bytesandbolts/lettera/pietroleoni_letteraREV1/Lettera Cost sheet.pdf

Item | Unit Price | Units | Subtotal
Phidgets 3314_0 - 950g-cm Unipolar Stepper. (x2) | 7.14 | 1 | 7.14
Seed Studio general shaft joint -p3. (x2) | 1.99 | 2 | 3.98
LM8UU linear bearings. (x7) | 3.56 | 2 | 7.14
Hitech standard servo, able to operate at 5V. | 16.29 | 1 | 16.29
Microswitch. (x2) | 2.2 | 1 | 2.2
L293D | 1.29 | 2 | 2.58
7805T | 4.05 | 1 | 4.05
Total | 43.38

http://www.active-robots.com/pm42l-048-17-950g-cm-unipolar-stepperhttp://www.amazon.co.uk/SeeedStudio-General-Shaft-Source-BOOOLE/dp/B00WX2IKOGhttp://www.amazon.co.u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
http://www.amazon.co.uk/Hitec-Standard-HS-311Storage-Gears-Polyamide/dp/B0006O3WVEhttp://www.amazon.co.uk/10pcs-Tact-Switch-KW11-3Z-Microswitch/dp/B014LY9LEQ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
