bytesandbolts/lettera/(list of files, cad)

Other CAD files:
pietroleoni_letteraREV1/pietroleoni_letteraREV1.dxf
