bytesandbolts/lettera/pietroleoni_letteraREV1/pietroleoni_letteraREV1_manual.pdf

# lettera

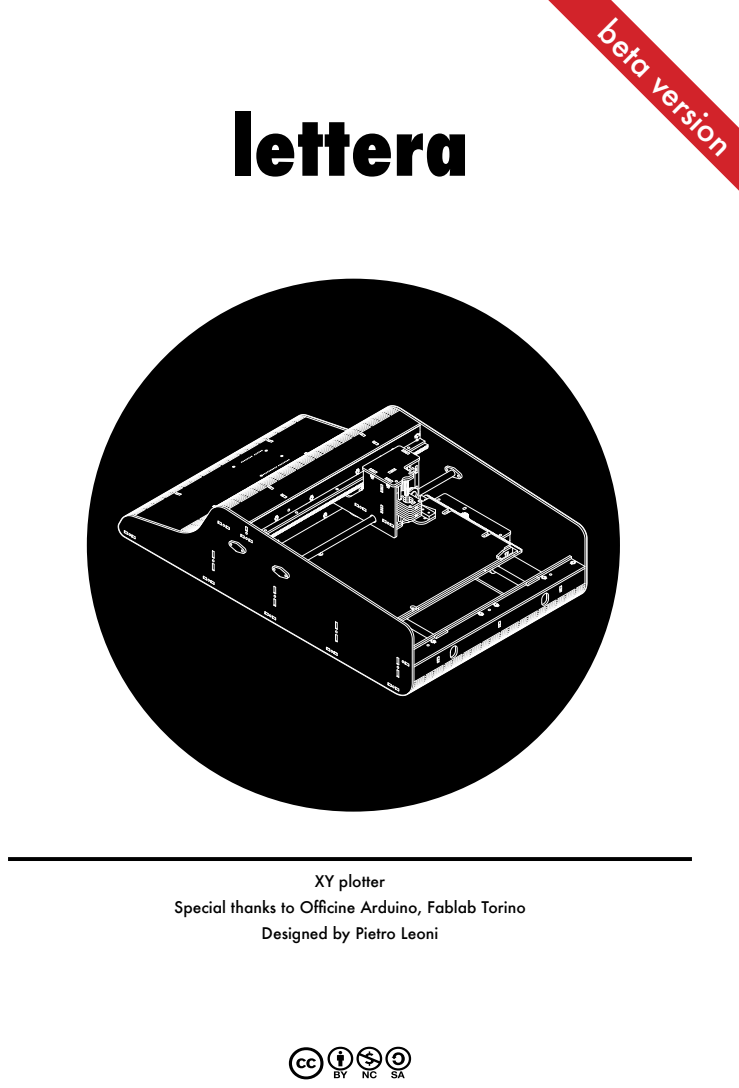
[picture p1: page 1]
beta version; XY plotter

Special thanks to Officine Arduino, Fablab Torino

Designed by Pietro Leoni

# connections and components

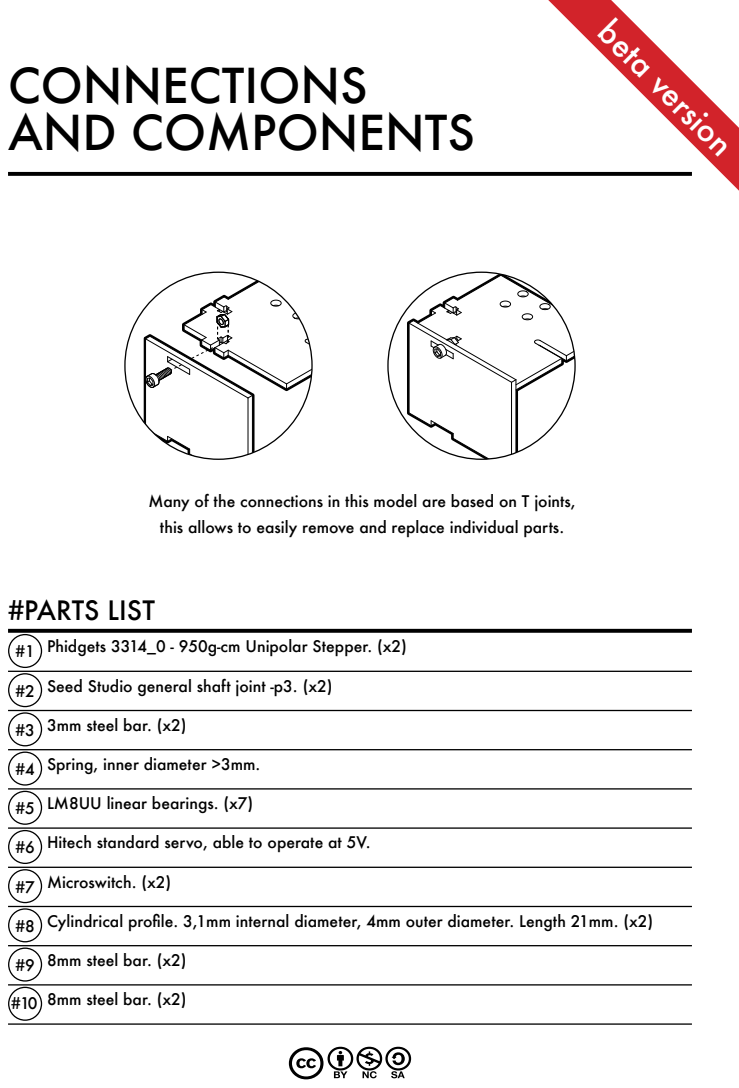
[picture p2: page 2]
beta version; #parts list

Many of the connections in this model are based on T joints,
this allows to easily remove and replace individual parts.

#1 Phidgets 3314_0 - 950g-cm Unipolar Stepper. (x2)
#2 Seed Studio general shaft joint -p3. (x2)
#3 3mm steel bar. (x2)
#4 Spring, inner diameter >3mm.
#5 LM8UU linear bearings. (x7)
#6 Hitech standard servo, able to operate at 5V.
#7 Microswitch. (x2)
#8 Cylindrical profile. 3,1mm internal diameter, 4mm outer diameter. Length 21mm. (x2)
#9 8mm steel bar. (x2)
#10 8mm steel bar. (x2)

# plans

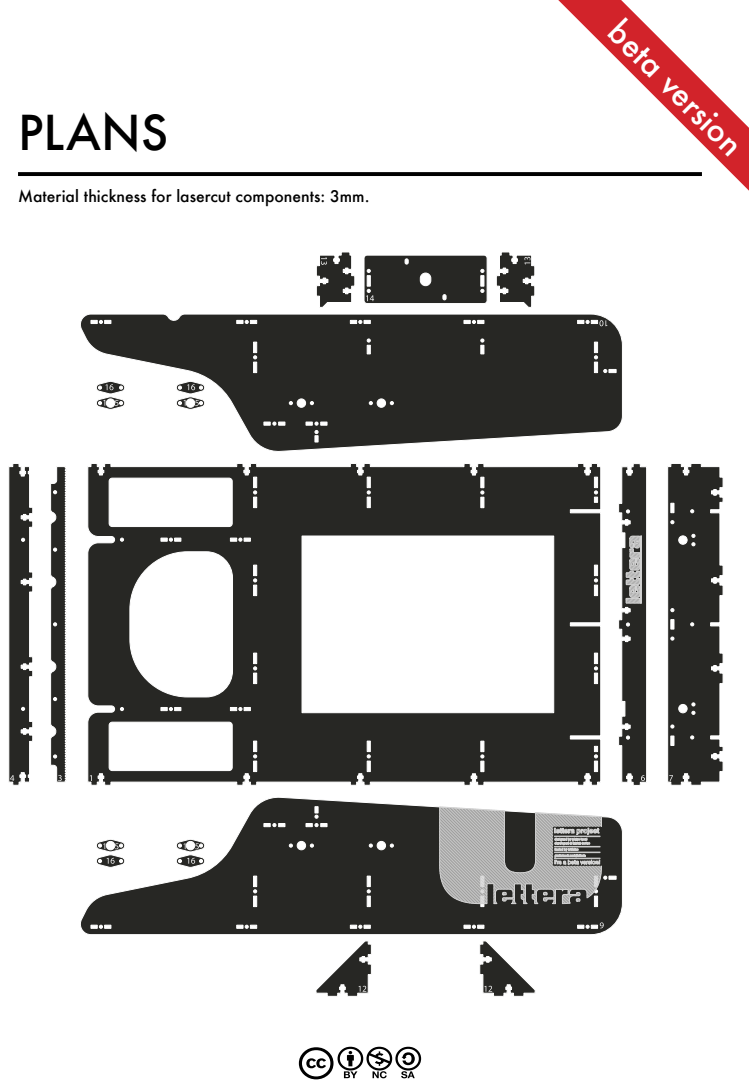
[picture p3: page 3]
beta version

Material thickness for lasercut components: 3mm.

# plans

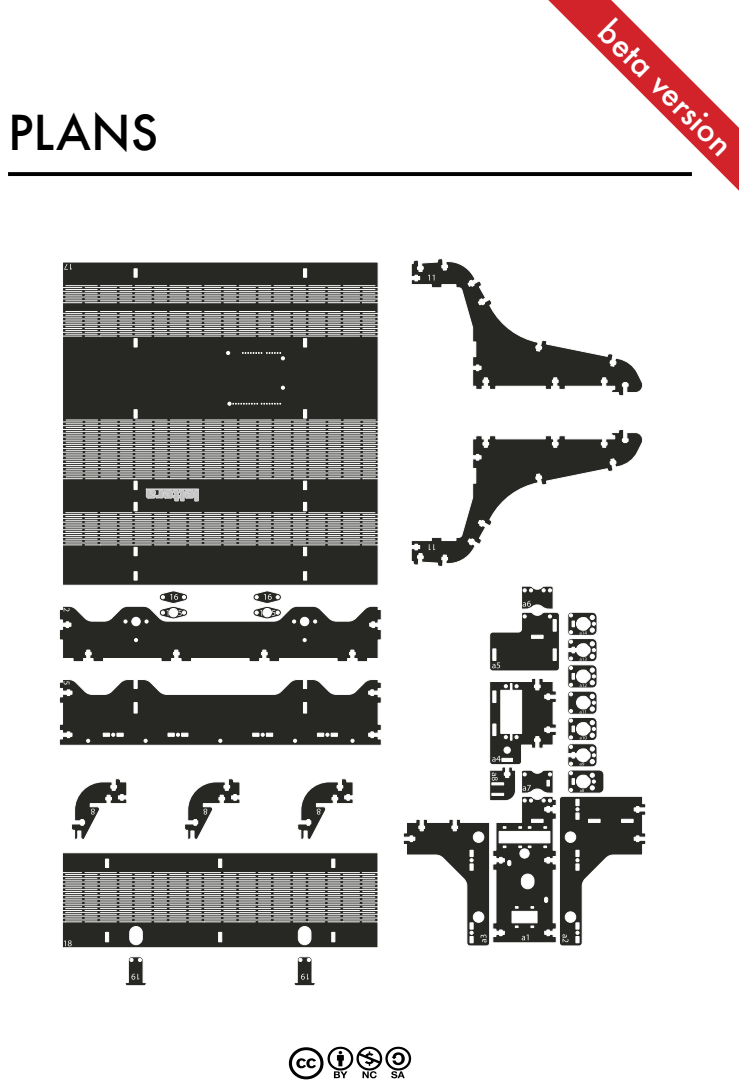
[picture p4: page 4]
beta version

# plans

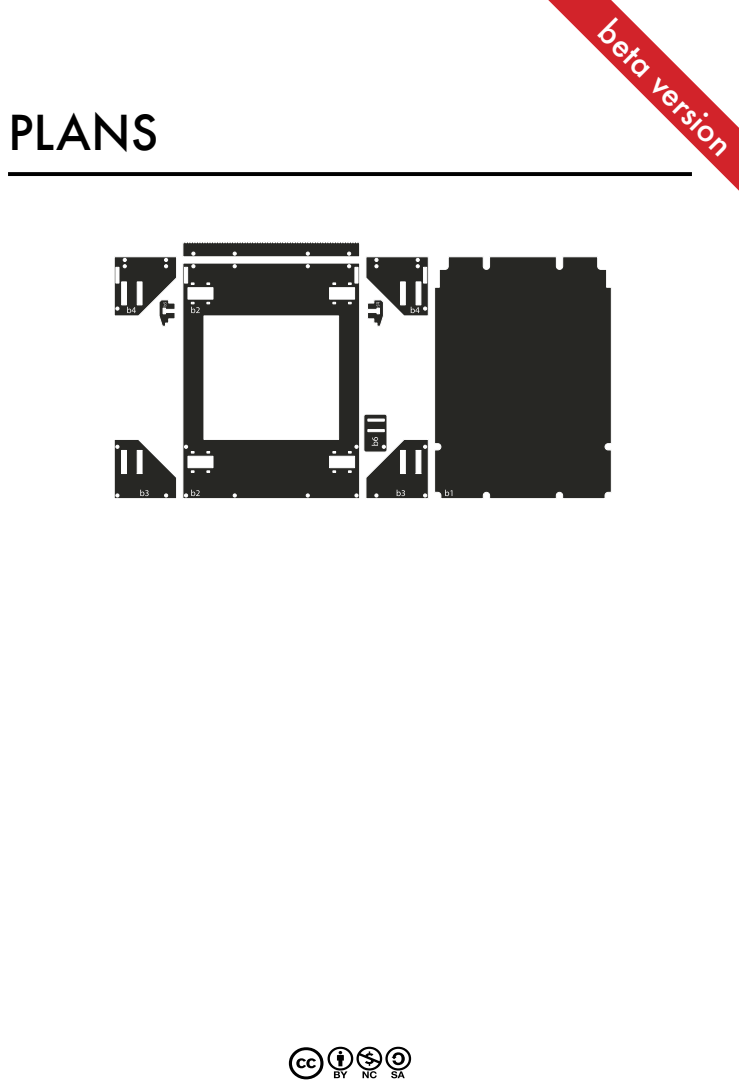
[picture p5: page 5]
beta version

# chassis

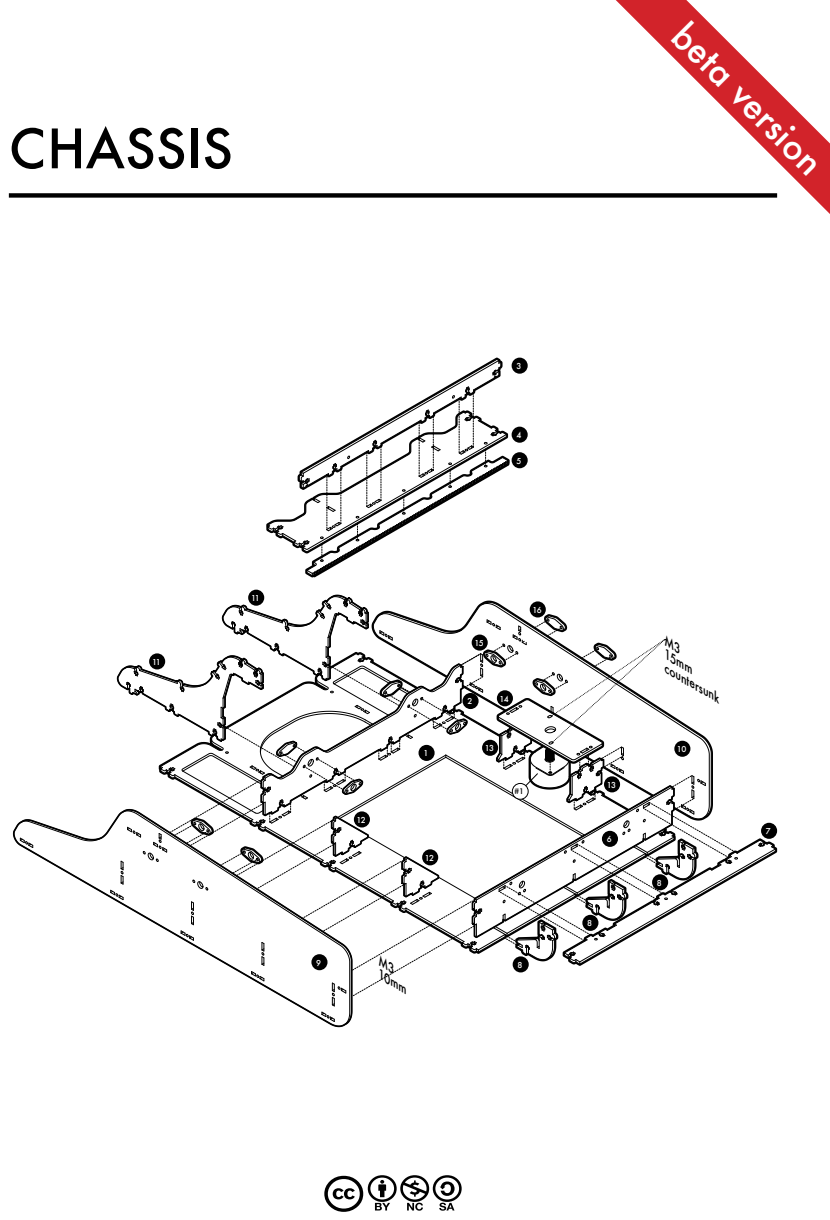
[picture p6: page 6]
beta version; M3 15mm countersunk

# chassis

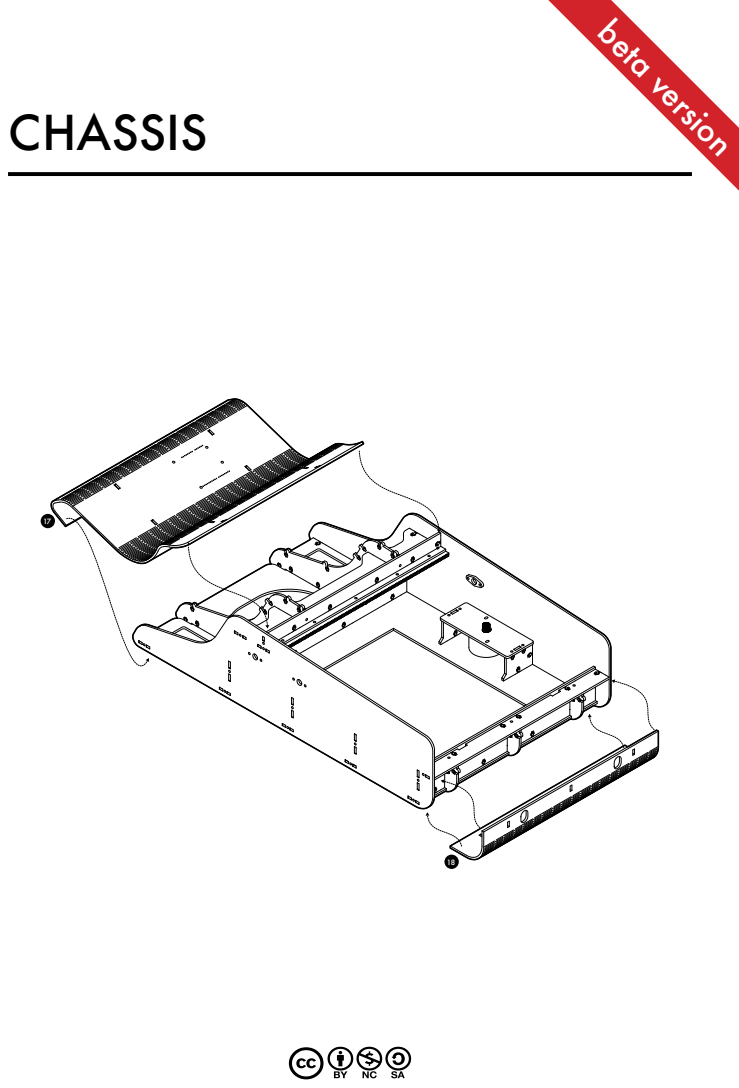
[picture p7: page 7]
beta version

# printhead

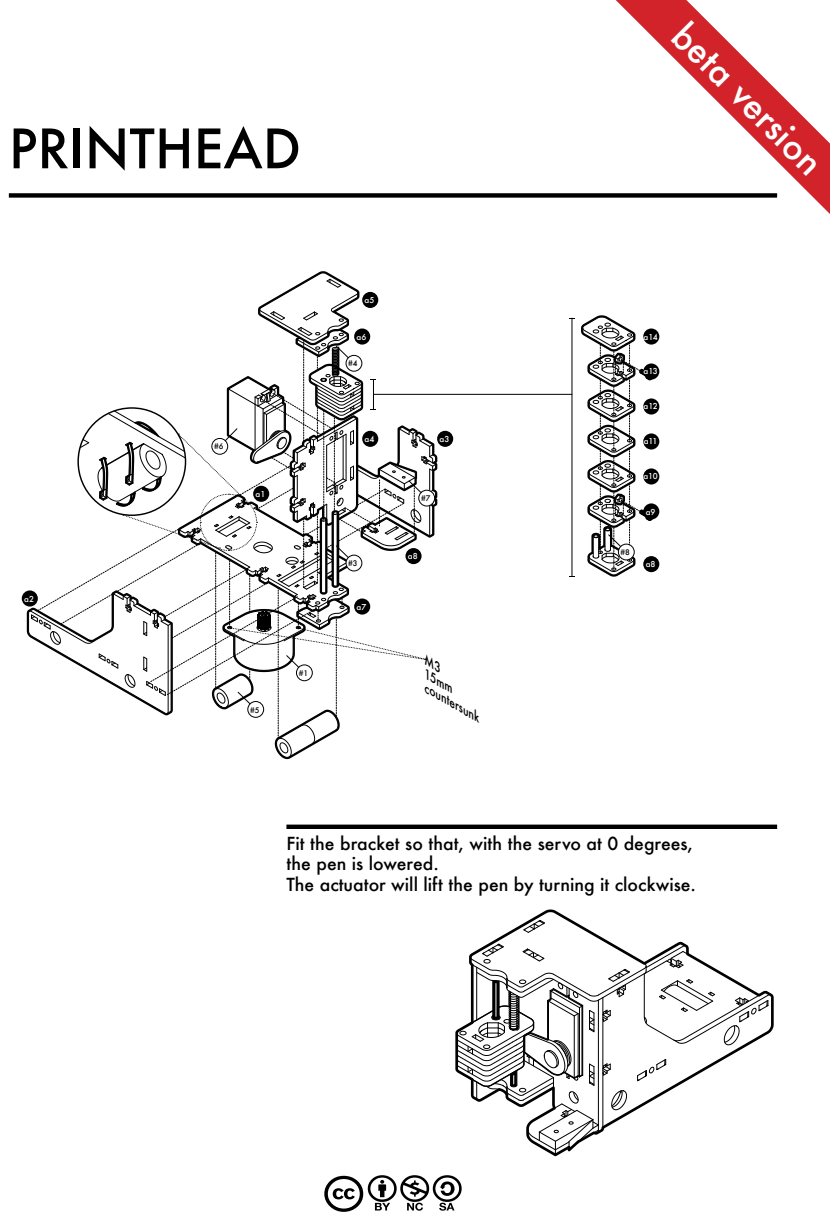
[picture p8: page 8]
beta version; M3 15mm countersunk

Fit the bracket so that, with the servo at 0 degrees,
the pen is lowered.
The actuator will lift the pen by turning it clockwise.

# printing plane

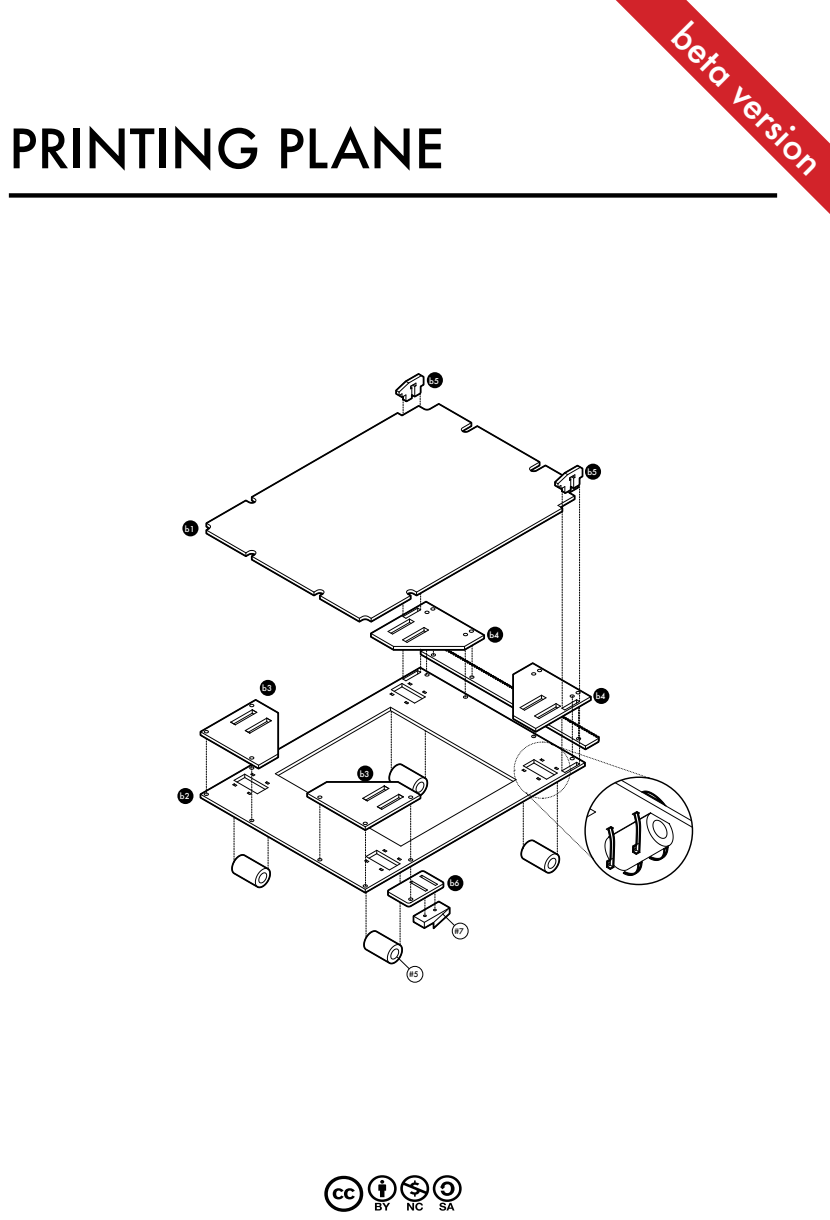
[picture p9: page 9]
beta version

# axes

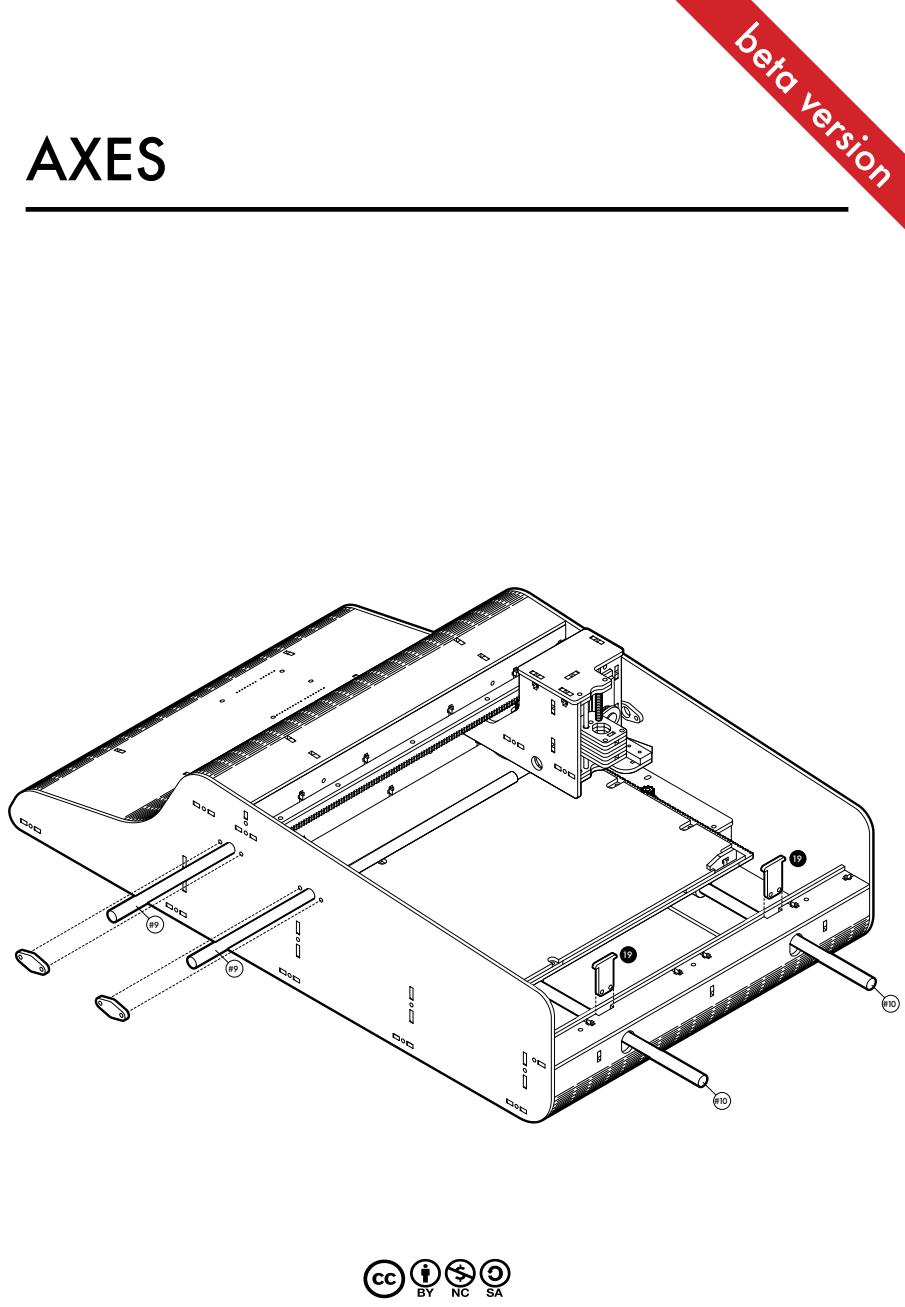
[picture p10: page 10]
beta version

# pen

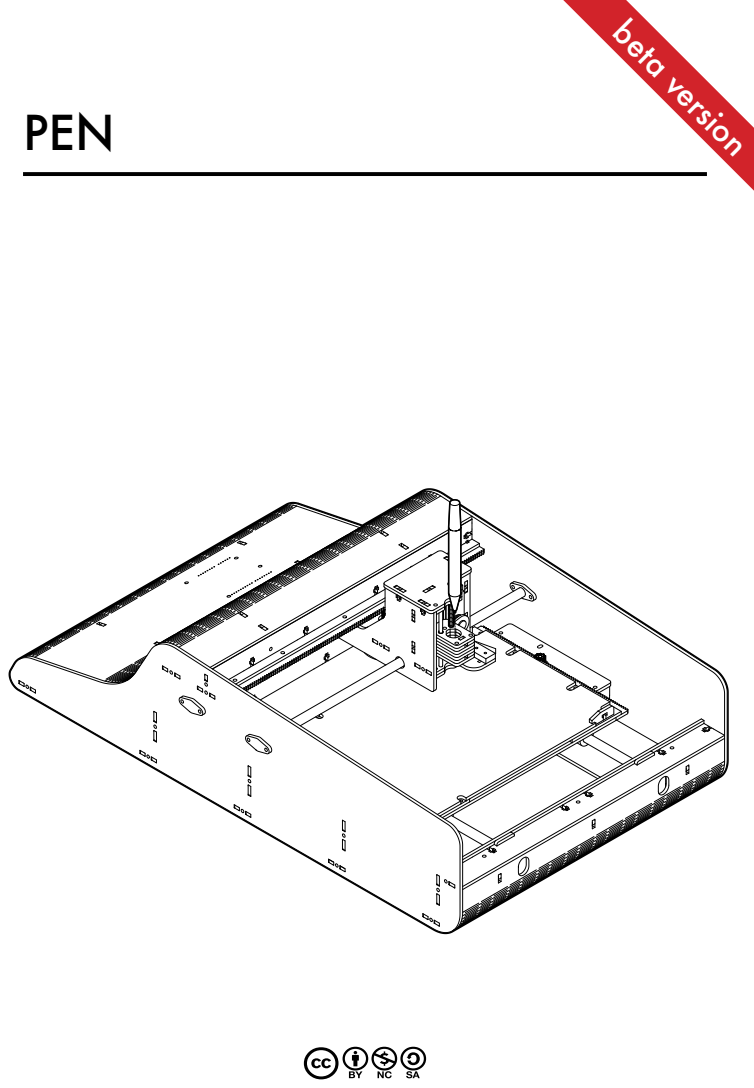
[picture p11: page 11]
beta version

# hardware

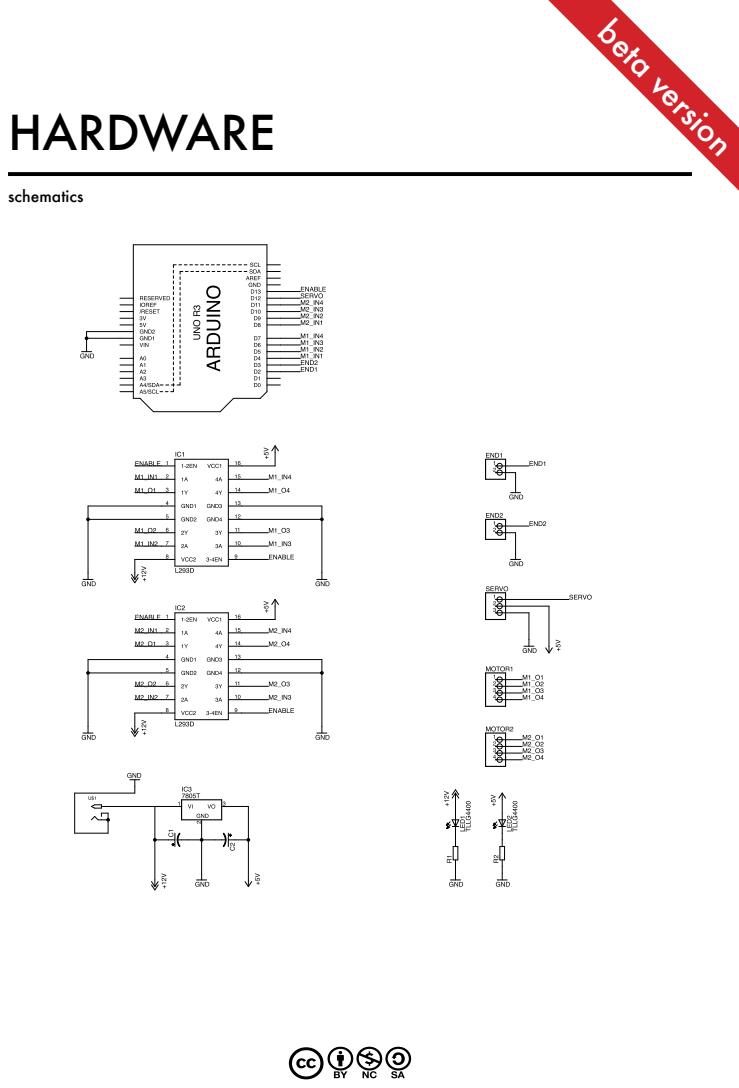
[picture p12: page 12]
beta version; schematics

# hardware

# goo.gl/S0Sn1k

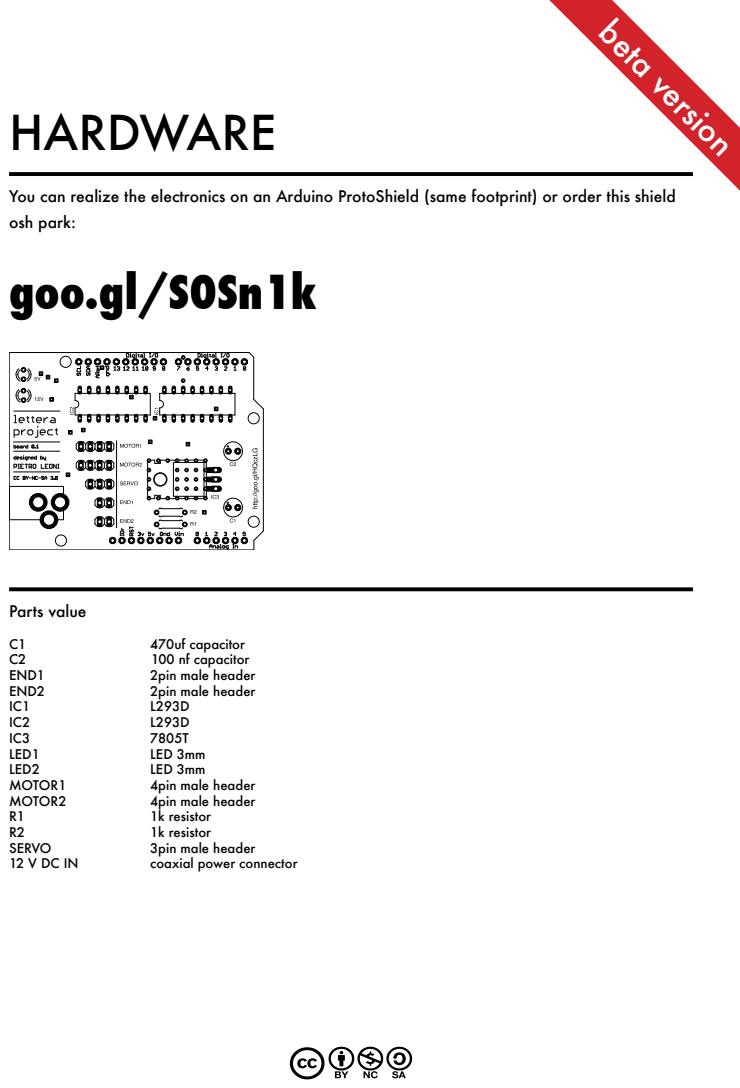
[picture p13: page 13]

You can realize the electronics on an Arduino ProtoShield (same footprint) or order this shield
osh park:

# wiring

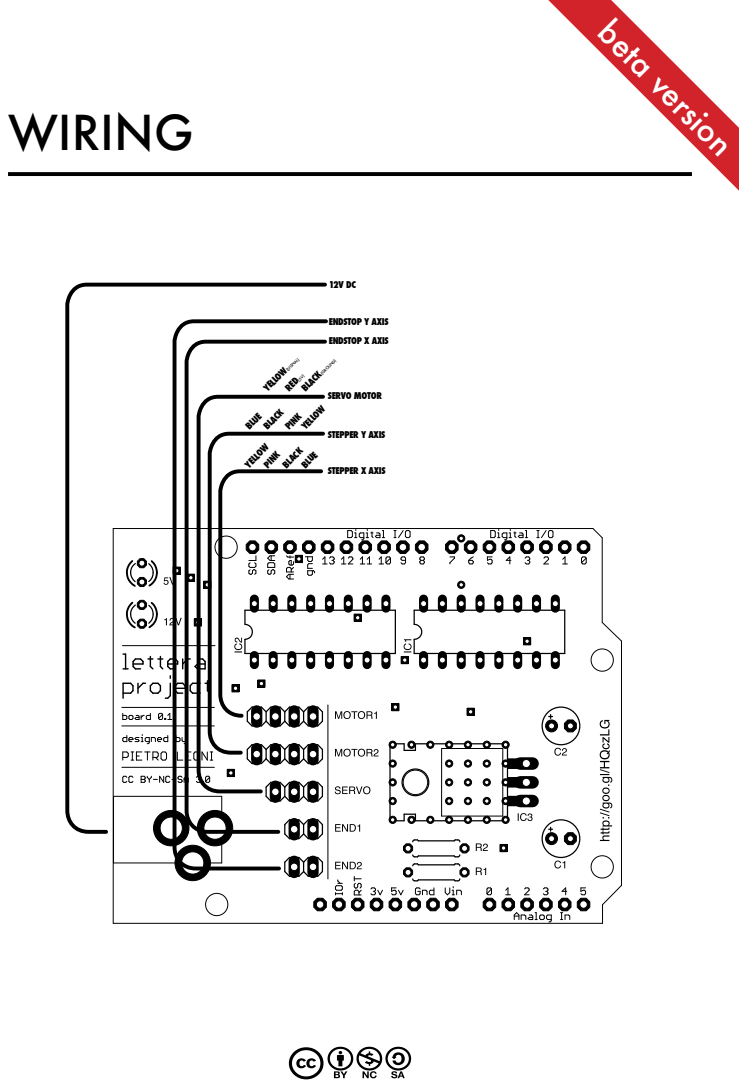
[picture p14: page 14]
beta version; yellow; black(ground) red(5v); pink; black; yellow(signal); blue; stepper X axis; stepper y axis; servo motor; endstop x axis; endstop y axis
