bytesandbolts/lettera/pietroleoni_letteraREV1/pietroleoni_letteraREV1.pdf

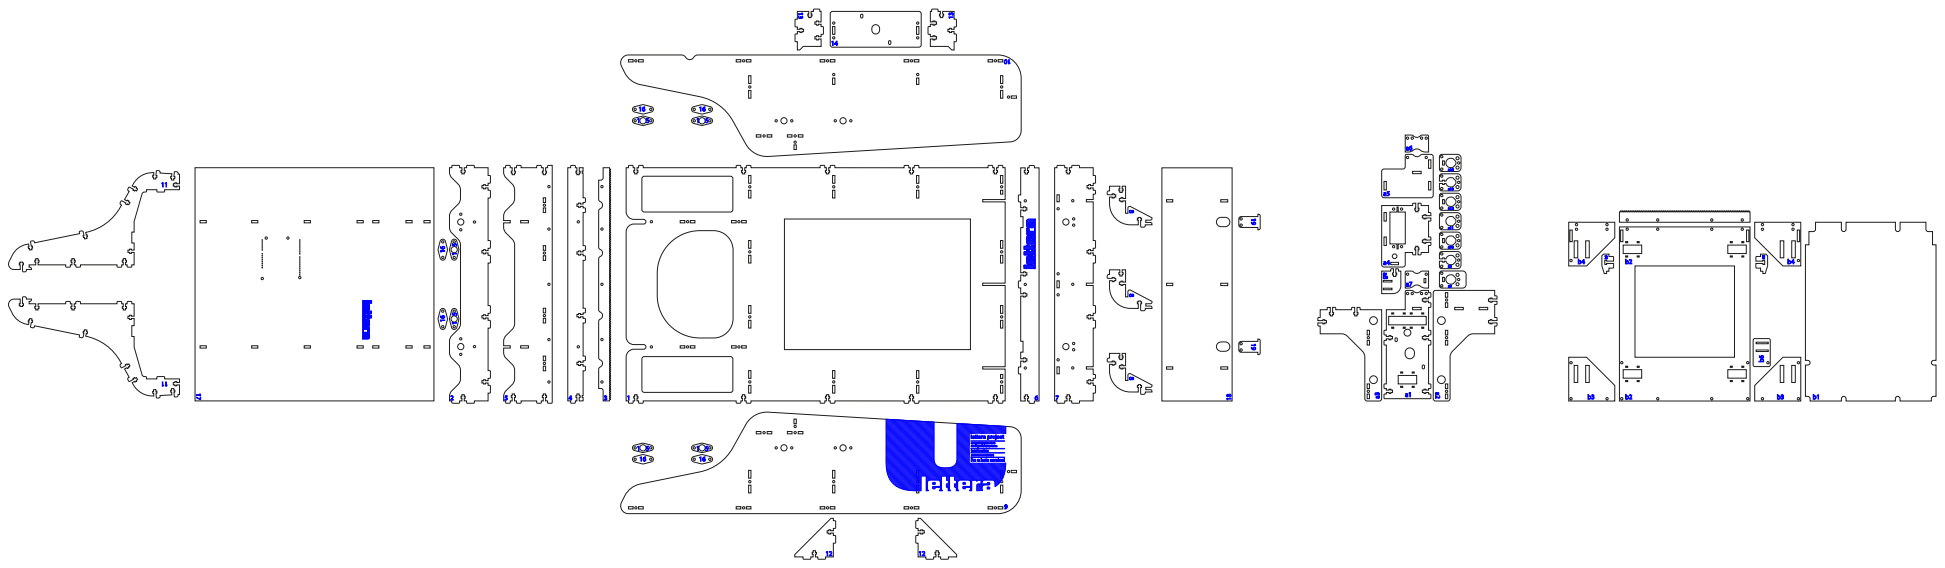
[picture p15: page 1]
