bytesandbolts/lettera/eagle/Lettera/Main.brd

## EAGLE design eagle/Lettera/Main.brd (2016-08-02)

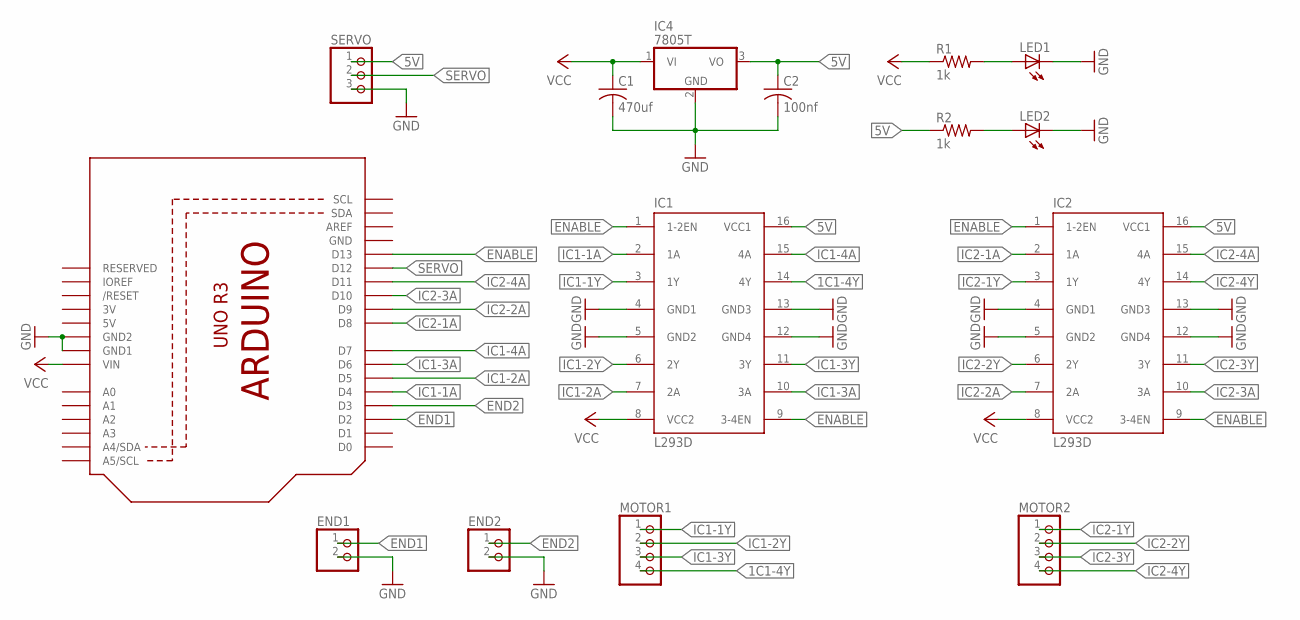
[picture p16: schematic Main.sch]

Parts:
C1: 470uf; C025-025X050
C2: 100nf; C025-025X050
END1, END2: PINHD-1X2; 1X02
IC1, IC2: L293D; DIL16
IC4: 7805T; TO220H
LED1, LED2: LED3MM
MOTOR1, MOTOR2: PINHD-1X4; 1X04
R1, R2: 1k; 0204/7
SERVO: PINHD-1X3; 1X03
U1: ARDUINOR3-BPLACE

Connections:
1C1-4Y: IC1.14 (4Y), MOTOR1.4
3V: U1.3V
5V: C2.1, IC1.16 (VCC1), IC2.16 (VCC1), IC4.3 (VO), R2.1, SERVO.1, U1.5V
ENABLE: IC1.1 (1-2EN), IC1.9 (3-4EN), IC2.1 (1-2EN), IC2.9 (3-4EN), U1.D13
END1: END1.1, U1.D2
END2: END2.1, U1.D3
GND: C1.2, C2.2, END1.2, END2.2, IC1.4 (GND1), IC1.5 (GND2), IC1.12 (GND4), IC1.13 (GND3), IC2.4 (GND1), IC2.5 (GND2), IC2.12 (GND4), IC2.13 (GND3), IC4.2 (GND), LED1.K (C), LED2.K (C), SERVO.3, U1.GND, U1.GND1, U1.GND2
IC1-1A: IC1.2 (1A), U1.D4
IC1-1Y: IC1.3 (1Y), MOTOR1.1
IC1-2A: IC1.7 (2A), U1.D5
IC1-2Y: IC1.6 (2Y), MOTOR1.2
IC1-3A: IC1.10 (3A), U1.D6
IC1-3Y: IC1.11 (3Y), MOTOR1.3
IC1-4A: IC1.15 (4A), U1.D7
IC2-1A: IC2.2 (1A), U1.D8
IC2-1Y: IC2.3 (1Y), MOTOR2.1
IC2-2A: IC2.7 (2A), U1.D9
IC2-2Y: IC2.6 (2Y), MOTOR2.2
IC2-3A: IC2.10 (3A), U1.D10
IC2-3Y: IC2.11 (3Y), MOTOR2.3
IC2-4A: IC2.15 (4A), U1.D11
IC2-4Y: IC2.14 (4Y), MOTOR2.4
unnamed: LED1.A, R1.2
unnamed: LED2.A, R2.2
SERVO: SERVO.2, U1.D12
VCC: C1.1, IC1.8 (VCC2), IC2.8 (VCC2), IC4.1 (VI), R1.1, U1.VIN

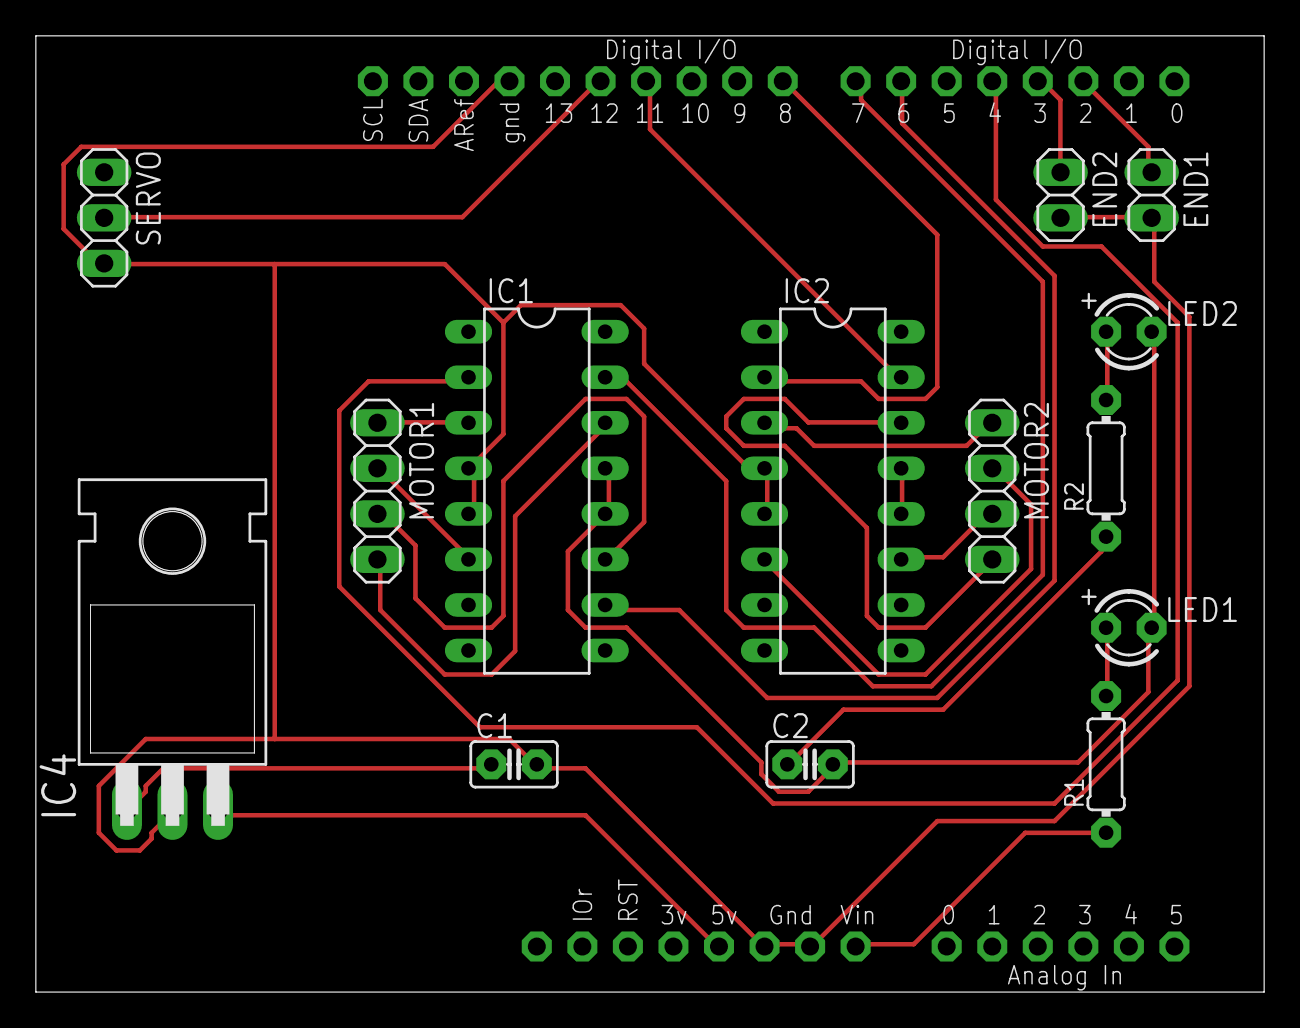
[picture p17: board Main.brd from above]

Board: 2 copper layers, 68.5 x 53.3 mm, 15 parts (0 on the bottom side), 25 nets.
