bytesandbolts/lettera/(notices)

Notices in the files:
pietroleoni_letteraREV1/design.brd:
CC BY-NC-SA 3.0
